PGRacing/WHEEL-07/README.md

# WHEEL-07

obraz
