PGRacing/WHEEL-07/3D_MODEL/HOUSING/HOUSING_WHL.SLDASM

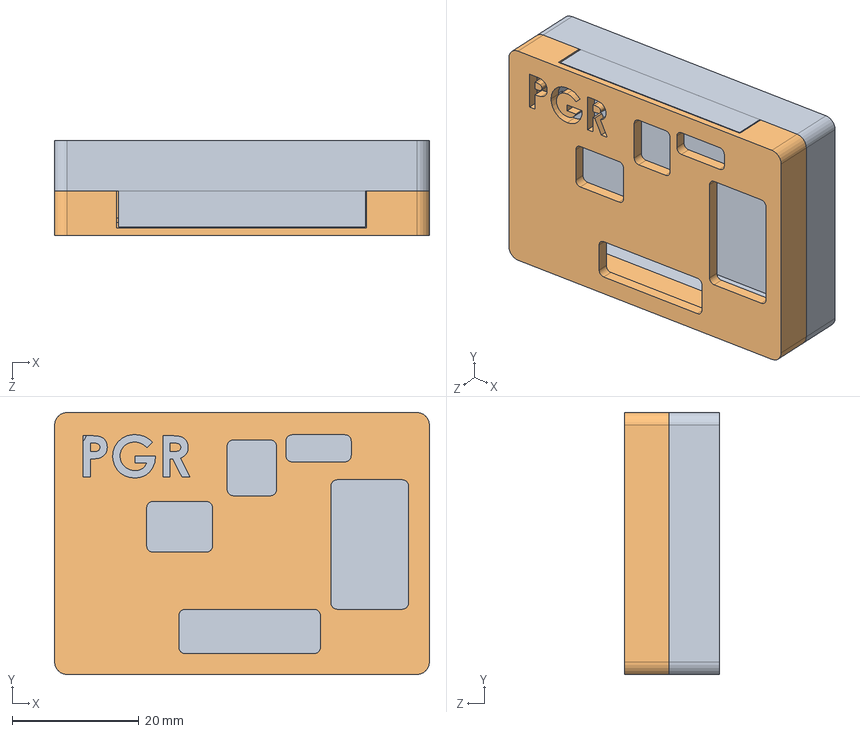
[picture p1: CAD file, 2024-10-11]
3D_MODEL/HOUSING/HOUSING_WHL.SLDASM
59.1 x 41.3 x 15.0 mm
HOUSING_WHL_BOTTOM
HOUSING_WHL_TOP
