PGRacing/WHEEL-07/3D_MODEL/HOUSING/WHEEL-07.step

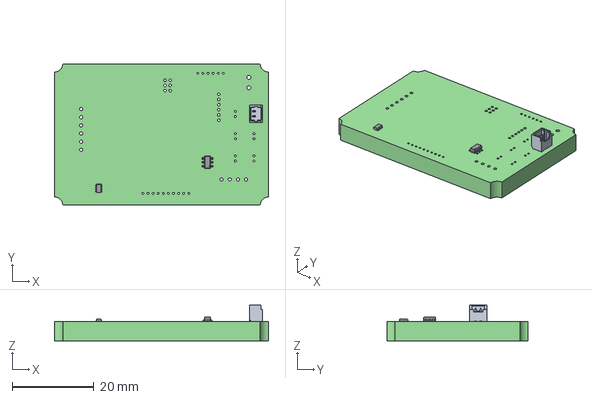
[picture p2: CAD file, 2024-10-11]
3D_MODEL/HOUSING/WHEEL-07.step
52.5 x 34.7 x 8.71 mm
WHEEL-07 PCB
