PGRacing/WHEEL-07/3D_MODEL/KNOBS/Rotary_Knob_V2_FINAL.STL

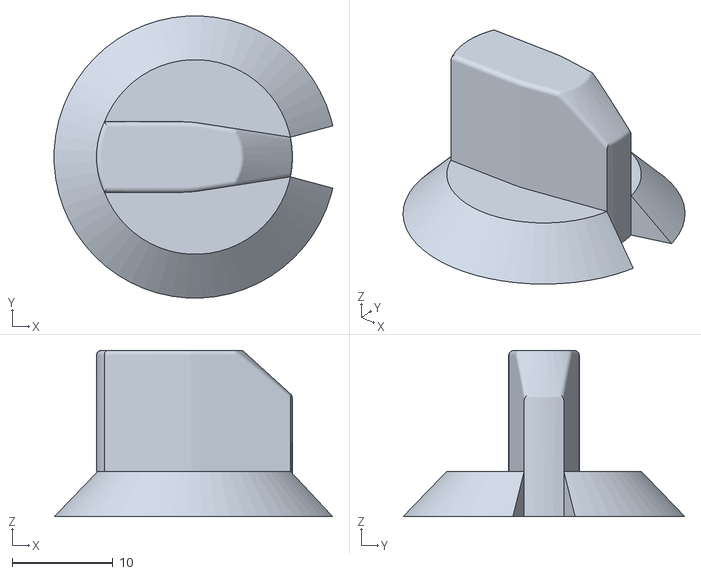
[picture p3: CAD file, 2024-10-06]
3D_MODEL/KNOBS/Rotary_Knob_V2_FINAL.STL
27.6 x 28.0 x 16.5
