PGRacing/WHEEL-07/PCB/WHEEL-07/ADDITIONAL/0022057025/22-05-7025.stp

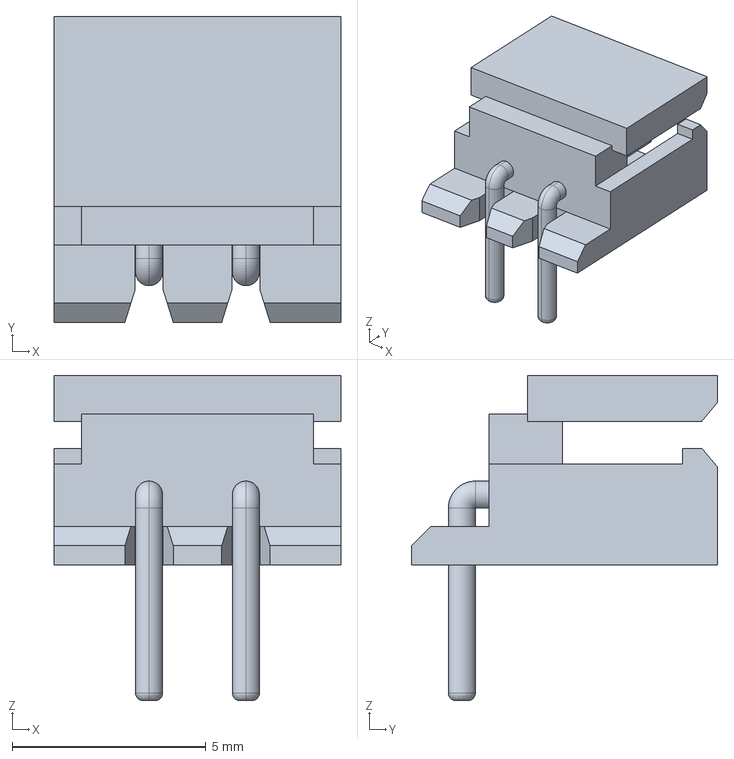
[picture p4: CAD file, 2023-02-24]
PCB/WHEEL-07/ADDITIONAL/0022057025/22-05-7025.stp
7.40 x 7.90 x 8.40 mm
