PGRacing/WHEEL-07/PCB/WHEEL-07/ADDITIONAL/LDO40LPU33RY/LDO40LPU33RY.stp

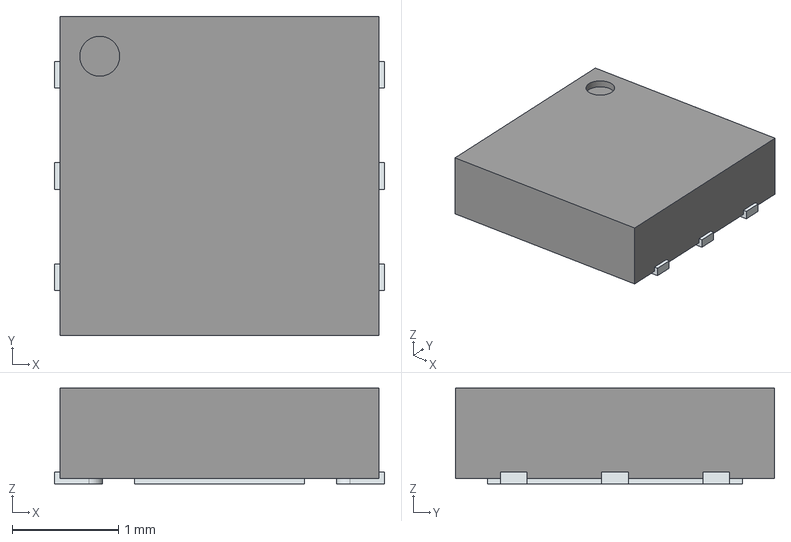
[picture p5: CAD file, 2024-10-12]
PCB/WHEEL-07/ADDITIONAL/LDO40LPU33RY/LDO40LPU33RY.stp
3.10 x 3.00 x 0.9 mm
ThermalPin
PinsArrayLR
