PGRacing/WHEEL-07/PCB/WHEEL-07/WHEEL-07.step

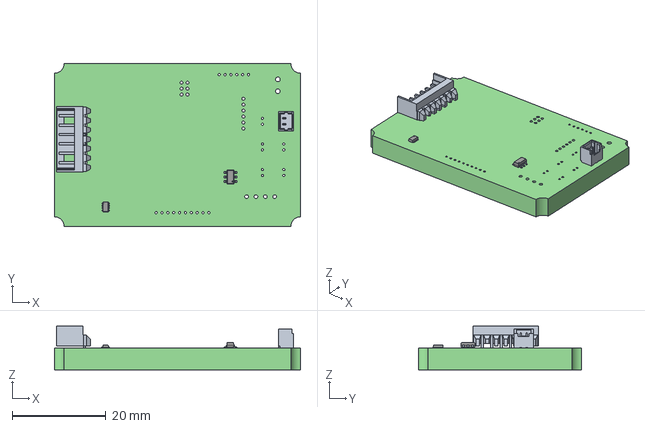
[picture p6: CAD file, 2023-03-17]
PCB/WHEEL-07/WHEEL-07.step
52.5 x 34.7 x 9.34 mm
WHEEL-07 PCB
