PGRacing/WHEEL-07/3D_MODEL/HOUSING/HOUSING_WHL - WHEEL-07.step-1 NL27WZ14DTT1G.step-1 COMPOUND.step-1.STL

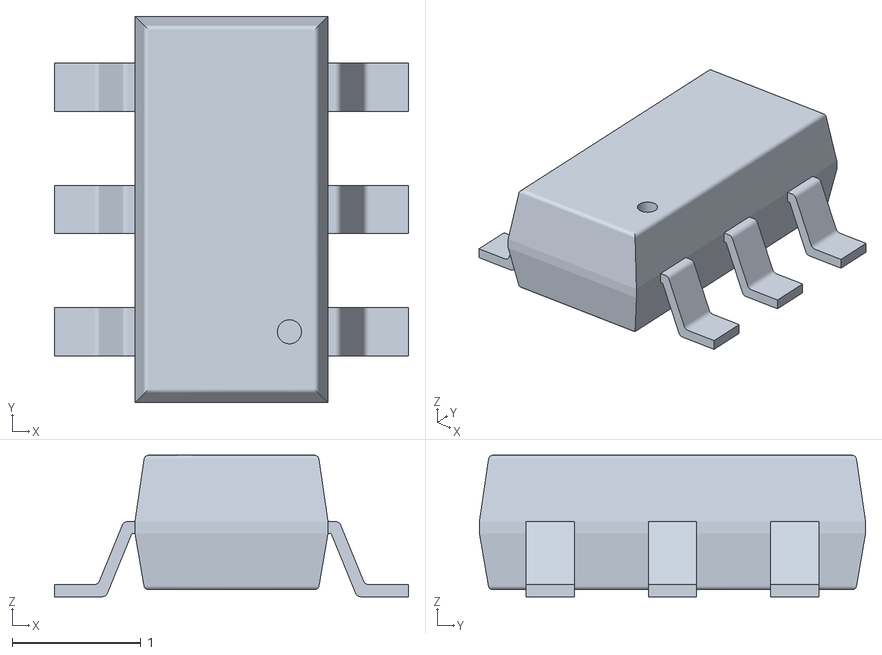
[picture p7: CAD file, 2024-10-11]
3D_MODEL/HOUSING/HOUSING_WHL - WHEEL-07.step-1 NL27WZ14DTT1G.step-1 COMPOUND.step-1.STL
2.75 x 3.00 x 1.10
