PGRacing/WHEEL-07/3D_MODEL/HOUSING/HOUSING_WHL_TOP_V2.STL

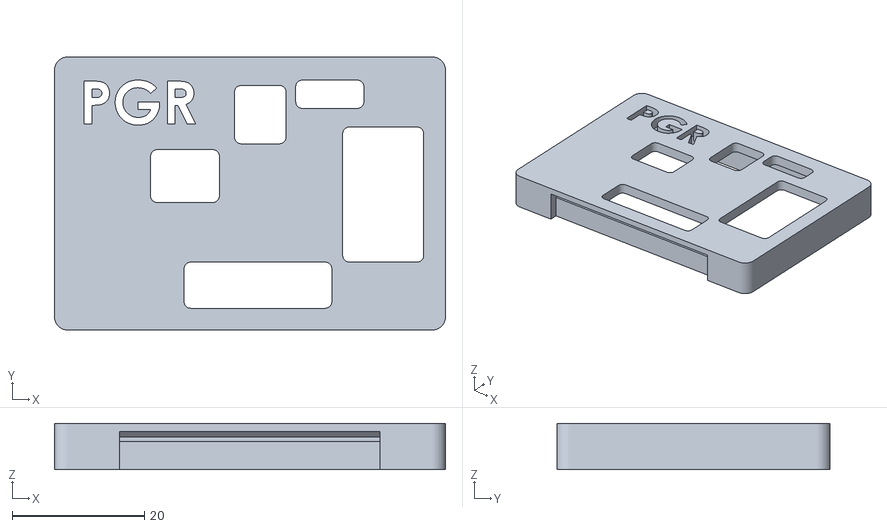
[picture p8: CAD file, 2024-10-11]
3D_MODEL/HOUSING/HOUSING_WHL_TOP_V2.STL
59.1 x 41.3 x 7.00
