PGRacing/WHEEL-07/3D_MODEL/KNOBS/ROTARY_SW.step

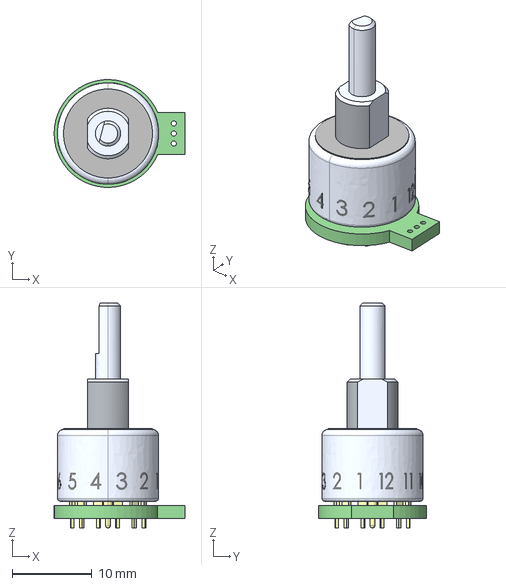
[picture p9: CAD file, 2023-02-25]
3D_MODEL/KNOBS/ROTARY_SW.step
16.4 x 13.5 x 28.2 mm
ROTARY_SW PCB
