PGRacing/WHEEL-07/3D_MODEL/HOUSING/HOUSING_WHL - HOUSING_WHL_BOTTOM-1.STL

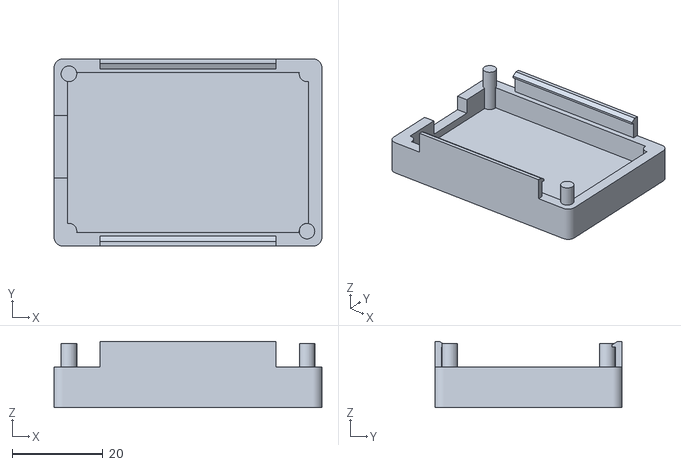
[picture p10: CAD file, 2024-10-11]
3D_MODEL/HOUSING/HOUSING_WHL - HOUSING_WHL_BOTTOM-1.STL
59.1 x 41.3 x 14.6
