PGRacing/WHEEL-07/3D_MODEL/HOUSING/HOUSING_WHL - WHEEL-07.step-1 MP2332HGTL-P.step-1 COMPOUND-1.step-1.STL

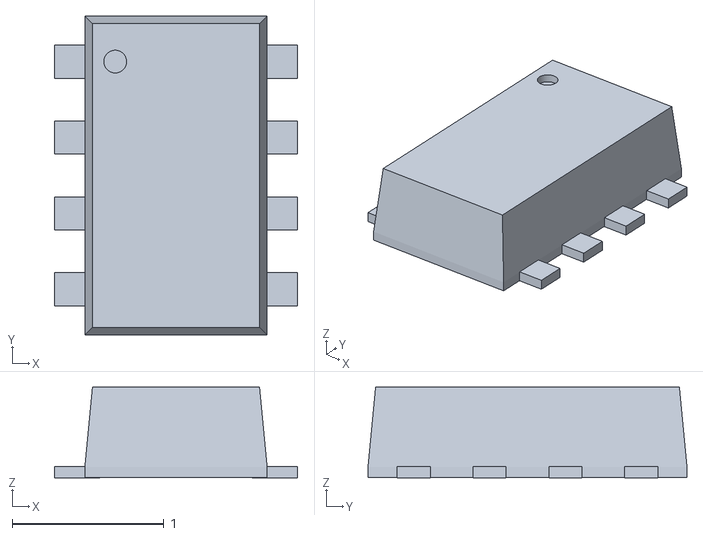
[picture p11: CAD file, 2024-10-11]
3D_MODEL/HOUSING/HOUSING_WHL - WHEEL-07.step-1 MP2332HGTL-P.step-1 COMPOUND-1.step-1.STL
1.60 x 2.10 x 0.598
