PGRacing/WHEEL-07/3D_MODEL/HOUSING/HOUSING_WHL - WHEEL-07.step-1 WHEEL-07 PCB.step-1.STL

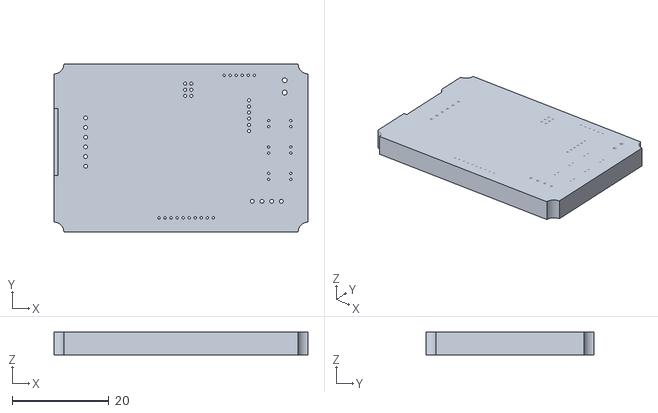
[picture p12: CAD file, 2024-10-11]
3D_MODEL/HOUSING/HOUSING_WHL - WHEEL-07.step-1 WHEEL-07 PCB.step-1.STL
52.5 x 34.7 x 4.69
