PGRacing/WHEEL-07/3D_MODEL/HOUSING/HOUSING_WHL - WHEEL-07.step-1 Molex_PicoBlade_53047-0210_1x02_P1.25mm_Vertical.wrl.step-1 COMPOUND-0.step-1.STL

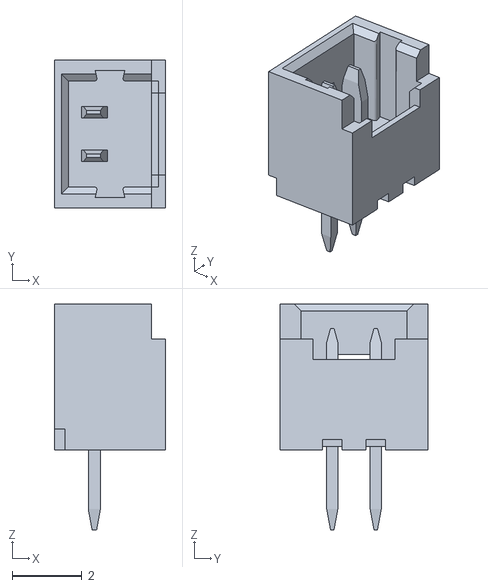
[picture p13: CAD file, 2024-10-11]
3D_MODEL/HOUSING/HOUSING_WHL - WHEEL-07.step-1 Molex_PicoBlade_53047-0210_1x02_P1.25mm_Vertical.wrl.step-1 COMPOUND-0.step-1.STL
3.20 x 4.25 x 6.50
