PGRacing/WHEEL-07/3D_MODEL/HOUSING/HOUSING_WHL_BOTTOM_V2.SLDPRT

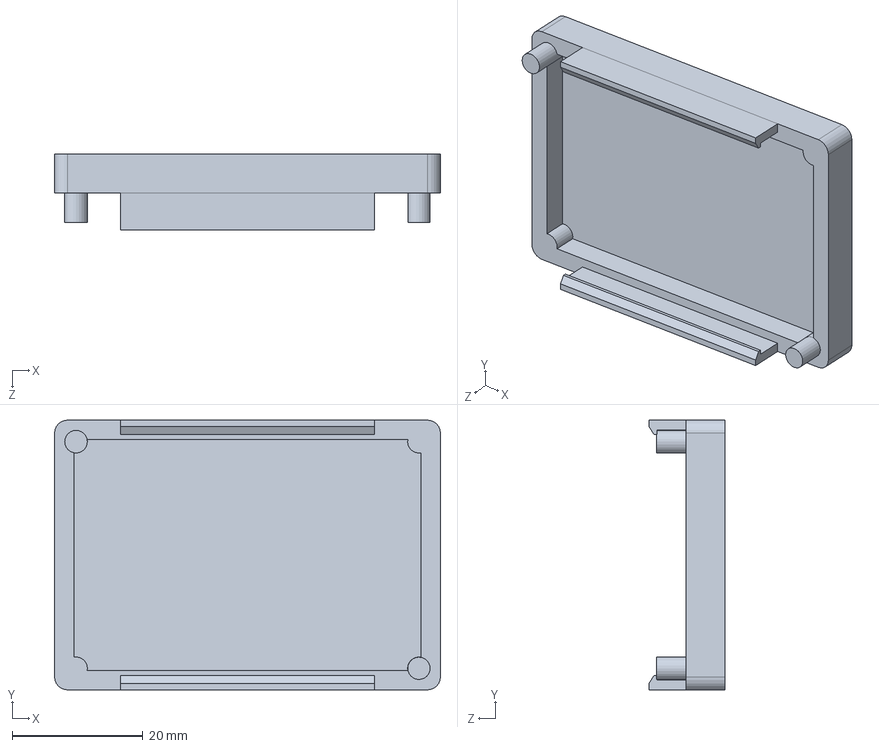
[picture p14: CAD file, 2024-10-11]
3D_MODEL/HOUSING/HOUSING_WHL_BOTTOM_V2.SLDPRT
59.1 x 41.3 x 11.6 mm
