PGRacing/WHEEL-07/(list of files, cad)

Other CAD files:
3D_MODEL/BOARD_WRL_NO_SIZE/wheel-07.wrl.SLDPRT
3D_MODEL/KNOBS/Rotary_Knob.SLDPRT
3D_MODEL/HOUSING/HOUSING_WHL_BOTTOM.SLDPRT
3D_MODEL/HOUSING/HOUSING_WHL_TOP.SLDPRT
3D_MODEL/HOUSING/HOUSING_WHL_BOTTOM_V2.3mf
3D_MODEL/HOUSING/HOUSING_WHL_BOTTOM_V2.STL
3D_MODEL/HOUSING/HOUSING_WHL_TOP.STL
3D_MODEL/KNOBS/ROTARY_SW.SLDASM
3D_MODEL/KNOBS/Rotary_Knob.STL
PCB/WHEEL-07/ADDITIONAL/0022057025/0022057025.stp
PCB/WHEEL-07/ADDITIONAL/53254-0670.stp
PCB/WHEEL-07/ADDITIONAL/87437-0243/87437-0243.stp
PCB/WHEEL-07/ADDITIONAL/87437-0243/87438-0243.stp
PCB/WHEEL-07/WHEEL-07..SLDASM
