PGRacing/WHEEL-07/PCB/WHEEL-07/WHEEL-07.kicad_pcb

## KiCad design PCB/WHEEL-07/WHEEL-07.kicad_pcb (2024-12-15)

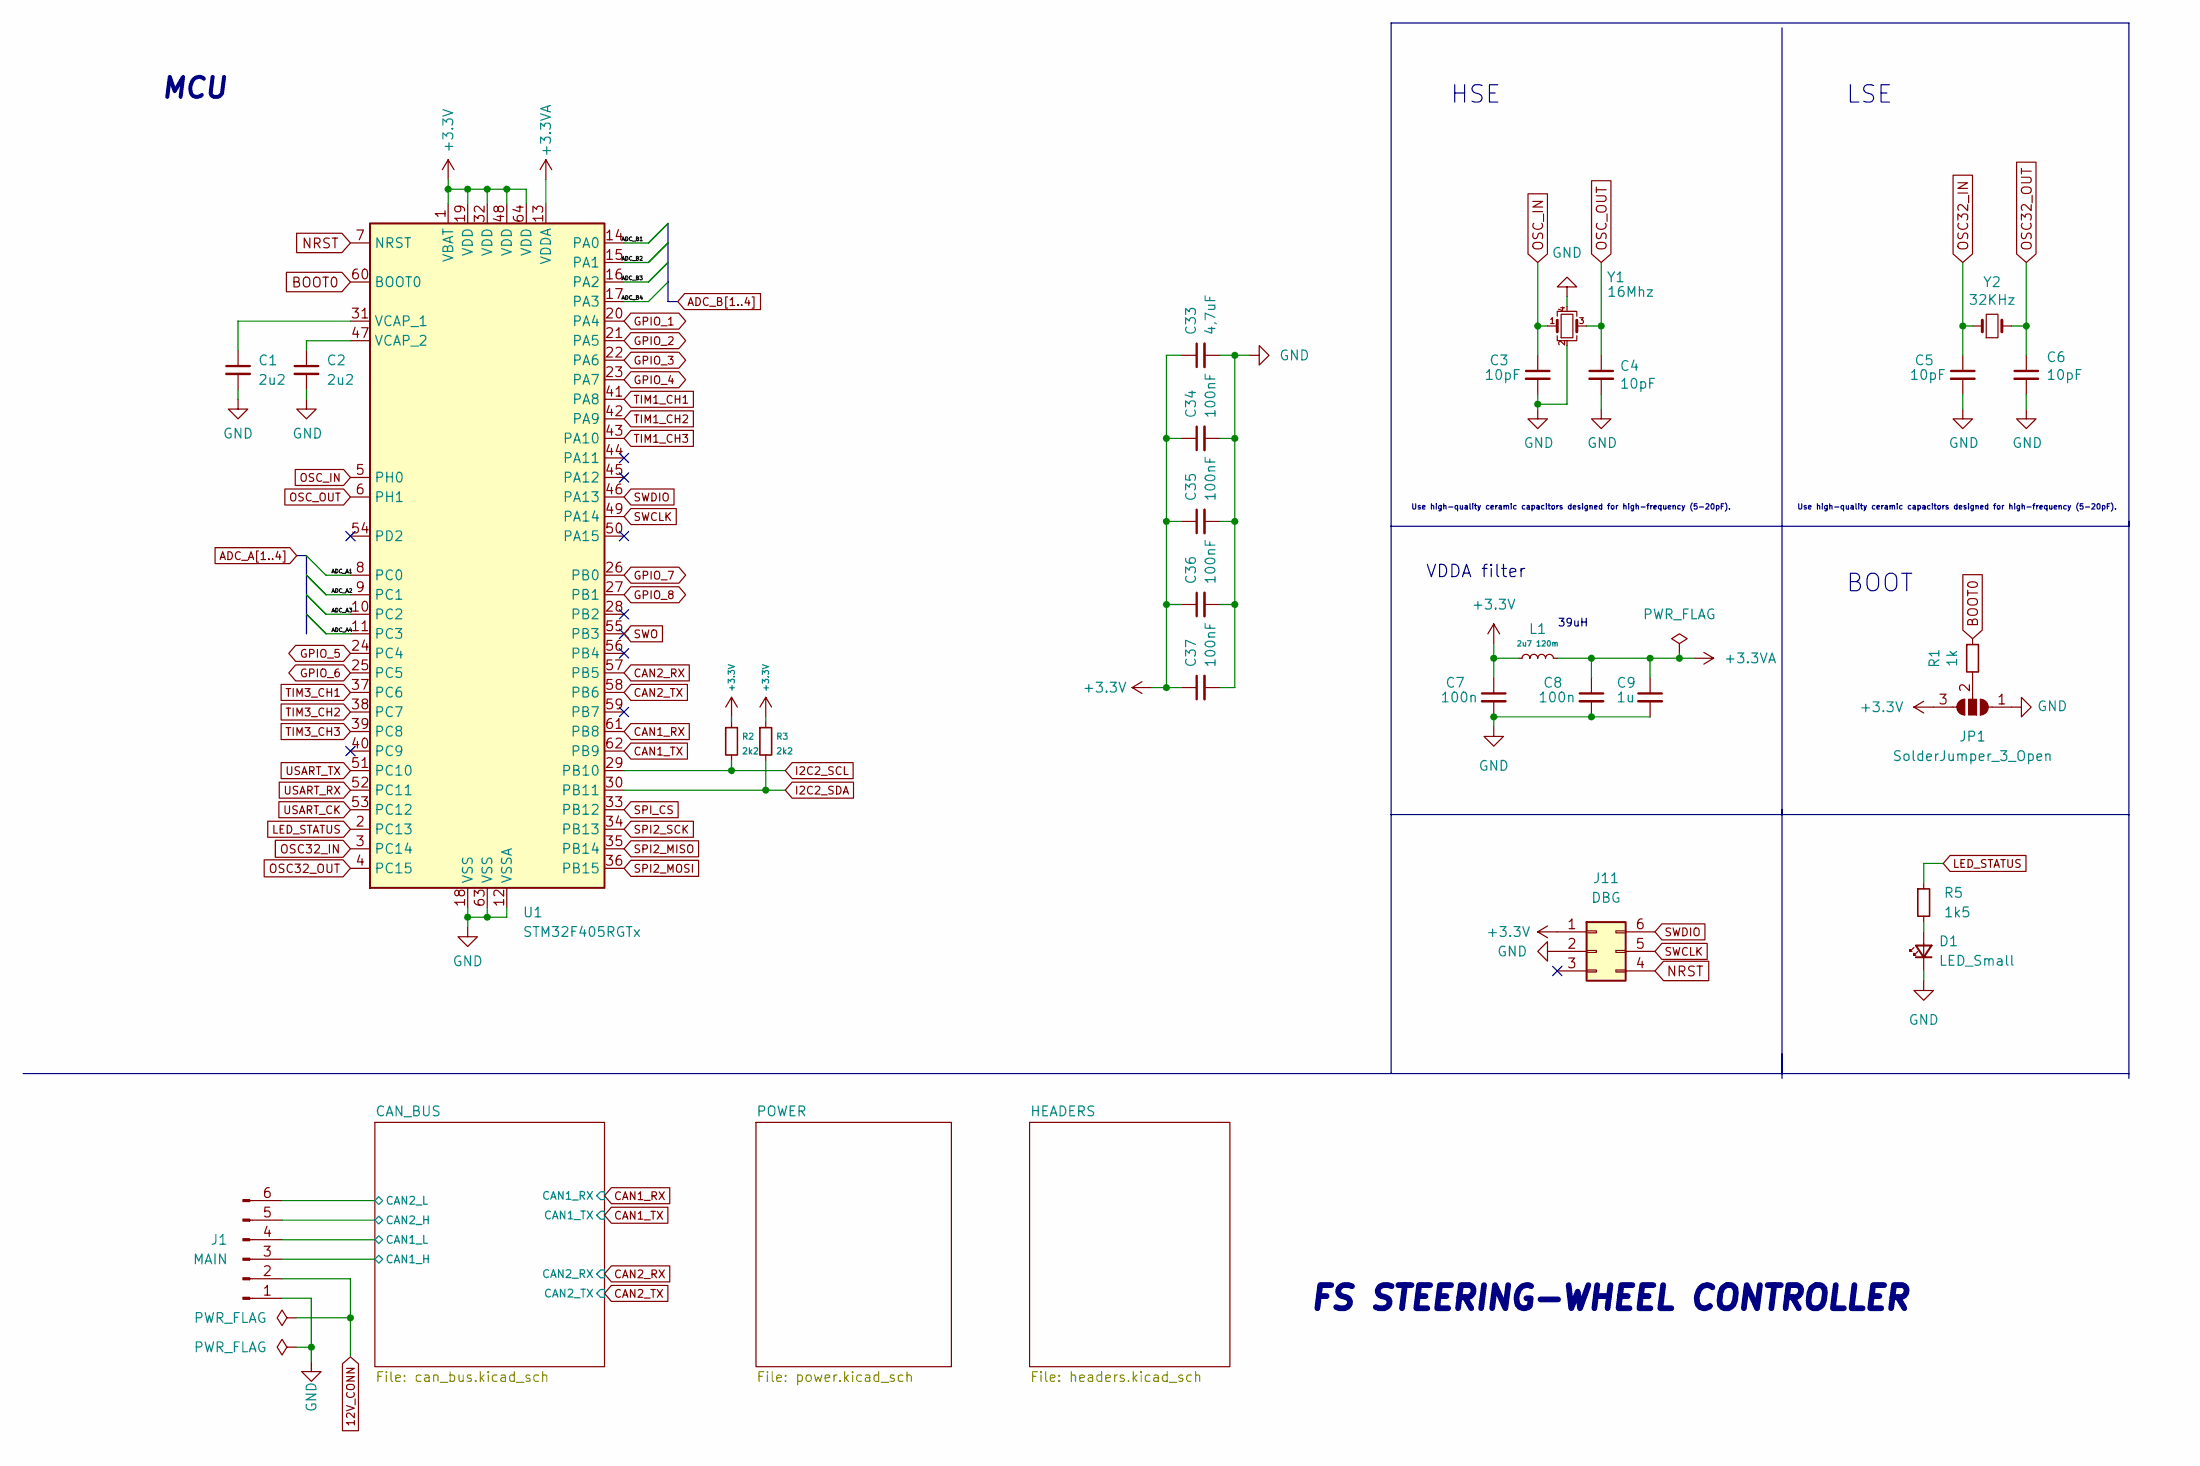
[picture p15: schematic WHEEL-07.kicad_sch]

Parts:
C1, C2: 2u2; C_0402_1005Metric_Pad0.74x0.62mm_HandSolder
C3, C4, C5, C6: 10pF; C_0402_1005Metric_Pad0.74x0.62mm_HandSolder
C7, C8: 100n; C_0402_1005Metric_Pad0.74x0.62mm_HandSolder
C9: 1u; C_0402_1005Metric_Pad0.74x0.62mm_HandSolder
C33: 4,7uF; C_0603_1608Metric
C34, C35, C36, C37: 100nF; C_0402_1005Metric_Pad0.74x0.62mm_HandSolder
D1: LED_Small; LED_0805_2012Metric
J1: MAIN; Molex_Micro-Latch_53254-0670_1x06_P2.00mm_Horizontal
J11: DBG; PinHeader_2x03_P1.27mm_Vertical
JP1: SolderJumper_3_Open; SolderJumper-3_P1.3mm_Open_RoundedPad1.0x1.5mm
L1: 2u7 120m; L_0402_1005Metric
R1: 1k; R_0402_1005Metric_Pad0.72x0.64mm_HandSolder
R2, R3: 2k2; R_0402_1005Metric_Pad0.72x0.64mm_HandSolder
R5: 1k5; R_0402_1005Metric_Pad0.72x0.64mm_HandSolder
U1: STM32F405RGTx; LQFP-64_10x10mm_P0.5mm
Y1: 16Mhz; Crystal_SMD_2016-4Pin_2.0x1.6mm
Y2: 32KHz; Crystal_SMD_3215-2Pin_3.2x1.5mm

Connections:
12V_CONN: J1.2; also elsewhere on the board
+3.3V: C7.1, C33.1, C34.1, C35.1, C36.1, C37.1, J11.1, JP1.3 (B), L1.1, R2.1, R3.1, U1.1 (VBAT), U1.19 (VDD), U1.32 (VDD), U1.48 (VDD), U1.64 (VDD); also elsewhere on the board
+3.3VA: C8.1, C9.1, L1.2, U1.13 (VDDA)
/CAN_BUS/CAN1_H: J1.3; also elsewhere on the board
/CAN_BUS/CAN1_L: J1.4; also elsewhere on the board
/CAN_BUS/CAN2_H: J1.5; also elsewhere on the board
/CAN_BUS/CAN2_L: J1.6; also elsewhere on the board
ADC_A1: U1.8 (PC0); also elsewhere on the board
ADC_A2: U1.9 (PC1); also elsewhere on the board
ADC_A3: U1.10 (PC2); also elsewhere on the board
ADC_A4: U1.11 (PC3); also elsewhere on the board
ADC_B1: U1.14 (PA0); also elsewhere on the board
ADC_B2: U1.15 (PA1); also elsewhere on the board
ADC_B3: U1.16 (PA2); also elsewhere on the board
ADC_B4: U1.17 (PA3); also elsewhere on the board
BOOT0: R1.1, U1.60 (BOOT0)
CAN1_RX: U1.61 (PB8); also elsewhere on the board
CAN1_TX: U1.62 (PB9); also elsewhere on the board
CAN2_RX: U1.57 (PB5); also elsewhere on the board
CAN2_TX: U1.58 (PB6); also elsewhere on the board
GND: C1.2, C2.2, C3.2, C4.2, C5.2, C6.2, C7.2, C8.2, C9.2, C33.2, C34.2, C35.2, C36.2, C37.2, D1.1 (K), J1.1, J11.2, JP1.1 (A), U1.12 (VSSA), U1.18 (VSS), U1.63 (VSS), Y1.2, Y1.4; also elsewhere on the board
GPIO_1: U1.20 (PA4); also elsewhere on the board
GPIO_2: U1.21 (PA5); also elsewhere on the board
GPIO_3: U1.22 (PA6); also elsewhere on the board
GPIO_4: U1.23 (PA7); also elsewhere on the board
GPIO_5: U1.24 (PC4); also elsewhere on the board
GPIO_6: U1.25 (PC5); also elsewhere on the board
GPIO_7: U1.26 (PB0); also elsewhere on the board
GPIO_8: U1.27 (PB1); also elsewhere on the board
I2C2_SCL: R2.2, U1.29 (PB10); also elsewhere on the board
I2C2_SDA: R3.2, U1.30 (PB11); also elsewhere on the board
LED_STATUS: R5.1, U1.2 (PC13)
NRST: J11.4, U1.7 (NRST)
unnamed: C1.1, U1.31 (VCAP_1)
unnamed: C2.1, U1.47 (VCAP_2)
unnamed: D1.2 (A), R5.2
unnamed: JP1.2 (C), R1.2
OSC32_IN: C5.1, U1.3 (PC14), Y2.1
OSC32_OUT: C6.1, U1.4 (PC15), Y2.2
OSC_IN: C3.1, U1.5 (PH0), Y1.1
OSC_OUT: C4.1, U1.6 (PH1), Y1.3
SPI2_MISO: U1.35 (PB14); also elsewhere on the board
SPI2_MOSI: U1.36 (PB15); also elsewhere on the board
SPI2_SCK: U1.34 (PB13); also elsewhere on the board
SPI_CS: U1.33 (PB12); also elsewhere on the board
SWCLK: J11.5, U1.49 (PA14)
SWDIO: J11.6, U1.46 (PA13)
SWO: U1.55 (PB3)
TIM1_CH1: U1.41 (PA8); also elsewhere on the board
TIM1_CH2: U1.42 (PA9); also elsewhere on the board
TIM1_CH3: U1.43 (PA10); also elsewhere on the board
TIM3_CH1: U1.37 (PC6); also elsewhere on the board
TIM3_CH2: U1.38 (PC7); also elsewhere on the board
TIM3_CH3: U1.39 (PC8); also elsewhere on the board
USART_CK: U1.53 (PC12)
USART_RX: U1.52 (PC11)
USART_TX: U1.51 (PC10)

Notes on the sheet:
39uH
LSE
MCU
BOOT
Use high-quality ceramic capacitors designed for high-frequency (5-20pF).
HSE
VDDA filter
FS STEERING-WHEEL CONTROLLER

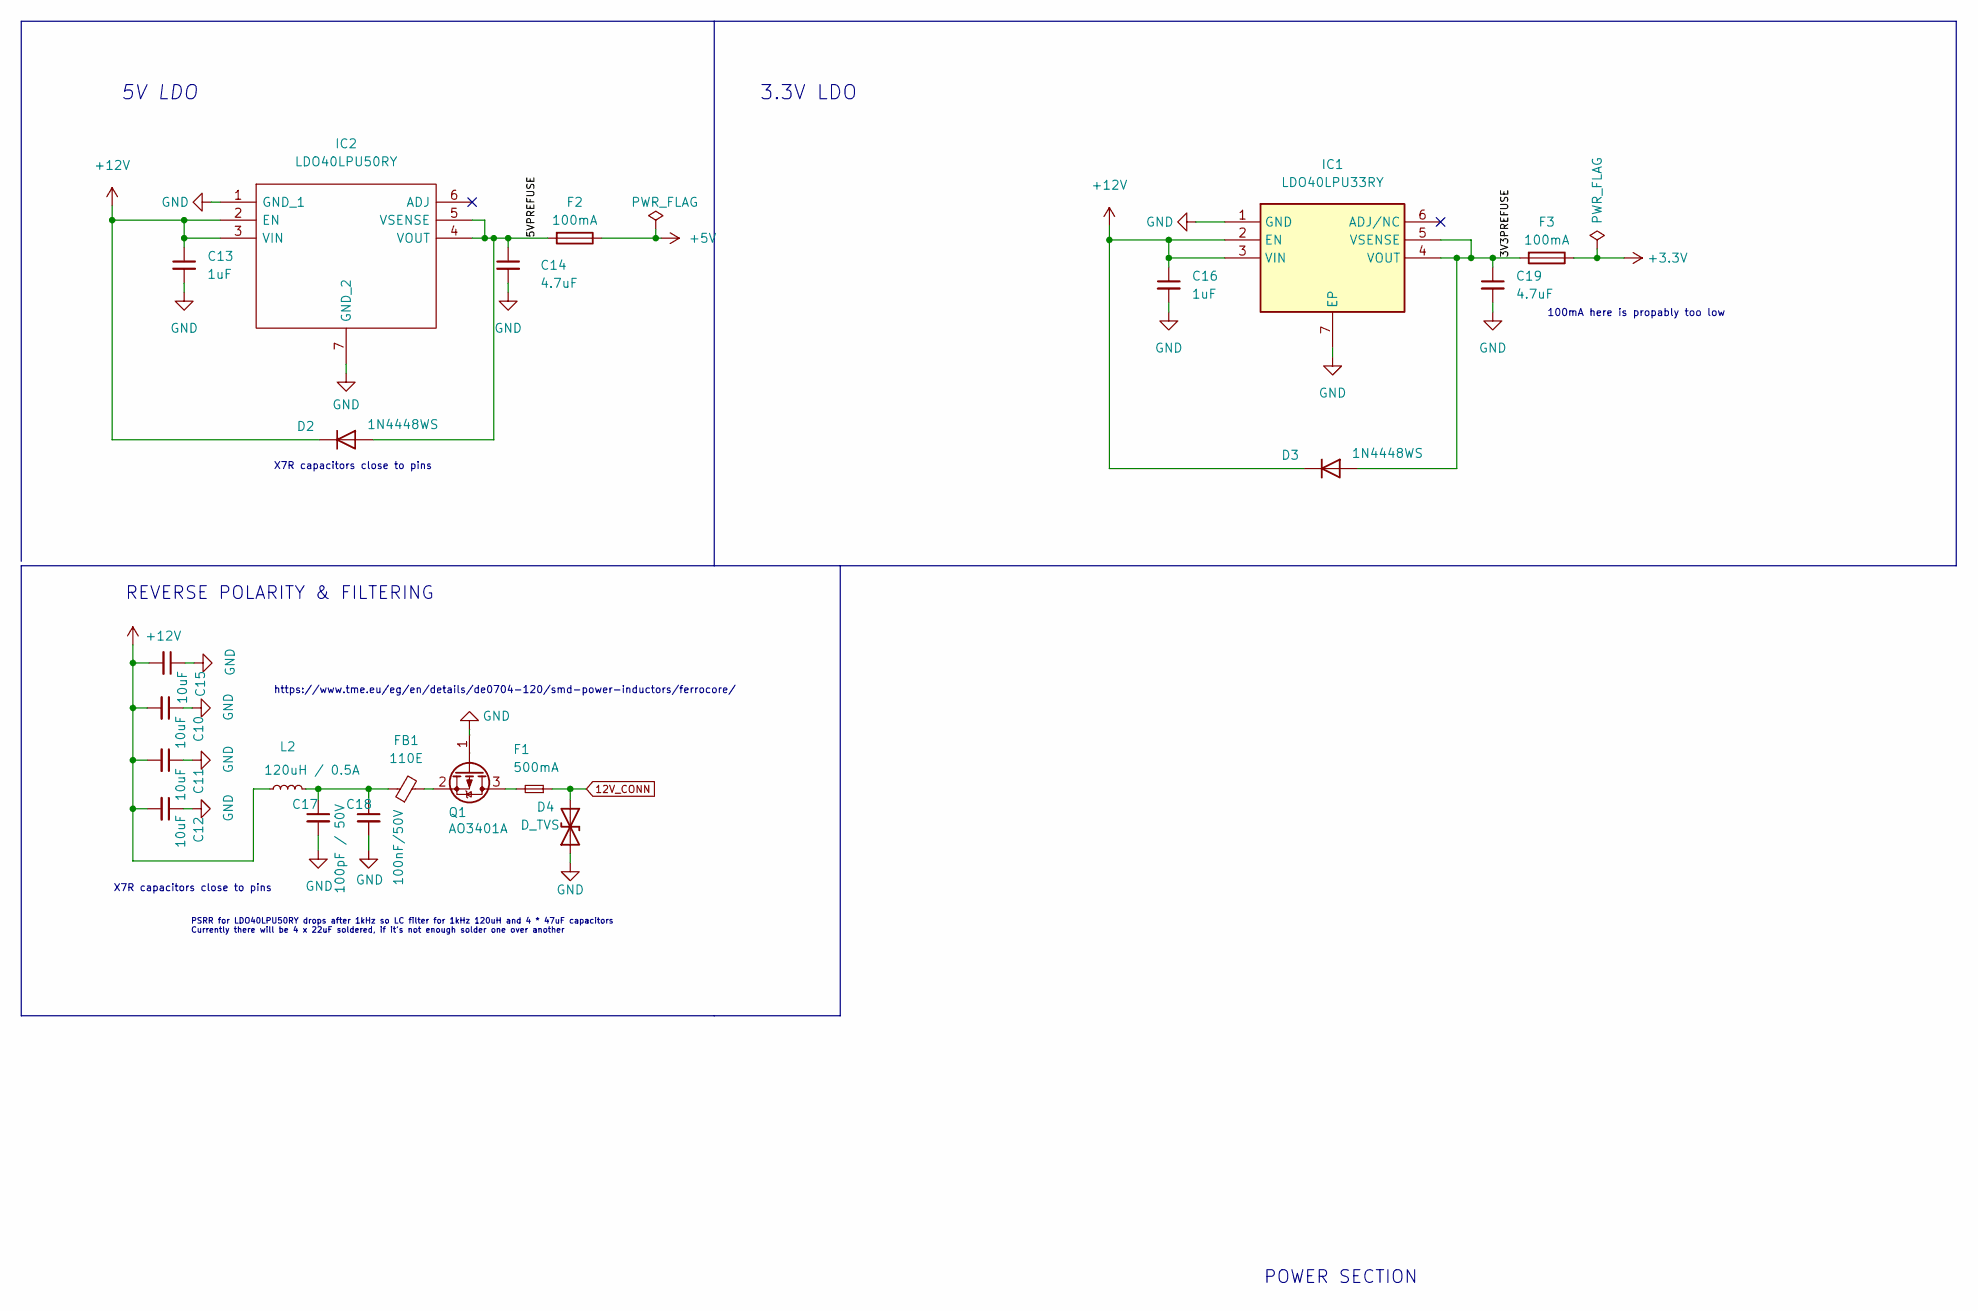
[picture p16: schematic power.kicad_sch]

Parts:
C10, C11, C12, C15: 10uF; C_1206_3216Metric
C13, C16: 1uF; C_0805_2012Metric
C14, C19: 4.7uF; C_0603_1608Metric
C17: 100pF / 50V; C_0402_1005Metric
C18: 100nF/50V; C_0402_1005Metric
D2, D3: 1N4448WS; D_SOD-323
D4: D_TVS; D_SMA
F1: 500mA; Fuse_0805_2012Metric
F2, F3: 100mA; Fuse_0805_2012Metric
FB1: 110E; LED_0805_2012Metric
IC1: LDO40LPU33RY; SON95P300X300X90-7N-D; Manufacturer_Part_Number LDO40LPU33RY; Mouser Part Number 511-LDO40LPU33RY
IC2: LDO40LPU50RY; SON95P300X300X90-7N-D; Manufacturer_Part_Number LDO40LPU50RY; Mouser Part Number 511-LDO40LPU50RY
L2: 120uH / 0.5A; L_7.3x7.3_H4.5
Q1: AO3401A; SOT-23

Connections:
12V_CONN: D4.2 (A2), F1.1; also elsewhere on the board
+3.3V: F3.1; also elsewhere on the board
+5V: F2.1; also elsewhere on the board
+12V: C10.2, C11.2, C12.2, C13.1, C15.2, C16.1, D2.1 (K), D3.1 (K), IC1.2 (EN), IC1.3 (VIN), IC2.2 (EN), IC2.3 (VIN), L2.1
/POWER/3V3PREFUSE: C19.1, D3.2 (A), F3.2, IC1.4 (VOUT), IC1.5 (VSENSE)
/POWER/5VPREFUSE: C14.1, D2.2 (A), F2.2, IC2.4 (VOUT), IC2.5 (VSENSE)
GND: C10.1, C11.1, C12.1, C13.2, C14.2, C15.1, C16.2, C17.2, C18.2, C19.2, D4.1 (A1), IC1.1 (GND), IC1.7 (EP), IC2.1 (GND_1), IC2.7 (GND_2), Q1.1 (G); also elsewhere on the board
unnamed: C17.1, C18.1, FB1.1, L2.2
unnamed: F1.2, Q1.3 (D)
unnamed: FB1.2, Q1.2 (S)

Notes on the sheet:
X7R capacitors close to pins
POWER SECTION
100mA here is propably too low
PSRR for LDO40LPU50RY drops after 1kHz so LC filter for 1kHz 120uH and 4 * 47uF capacitors Currently there will be 4 x 22uF soldered, if it's not enough solder one over another
https://www.tme.eu/eg/en/details/de0704-120/smd-power-inductors/ferrocore/
3.3V LDO
5V LDO
REVERSE POLARITY & FILTERING

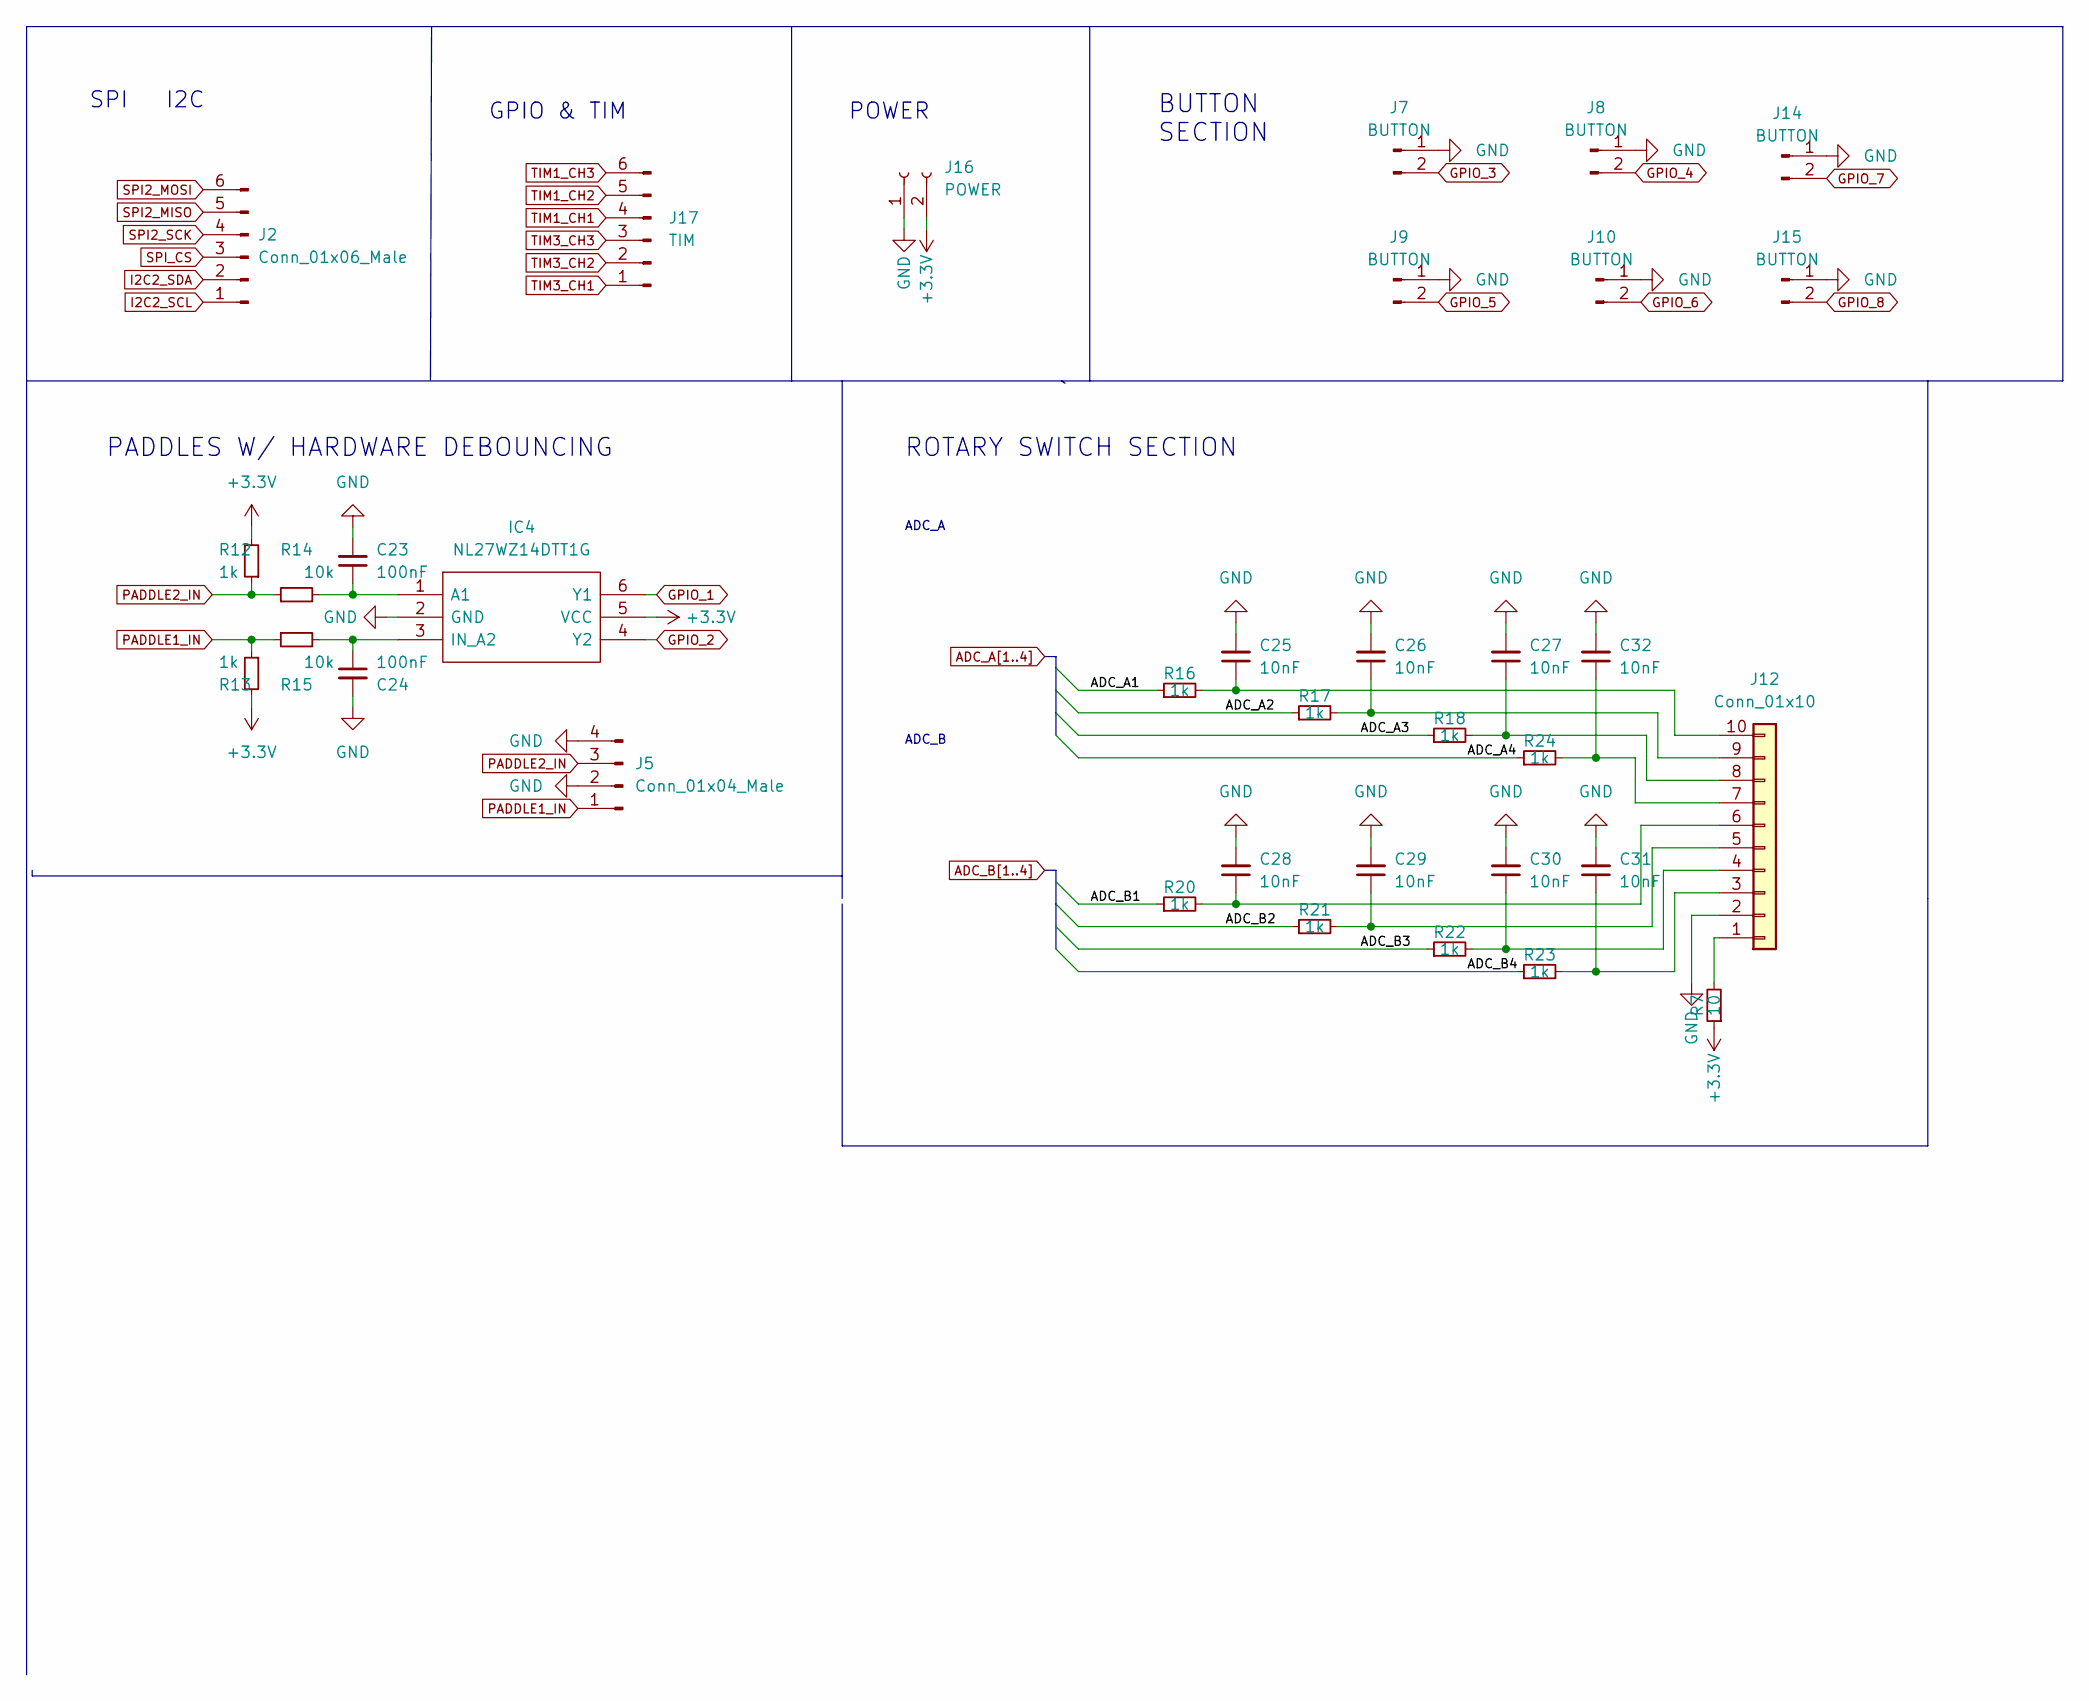
[picture p17: schematic headers.kicad_sch]

Parts:
C23, C24: 100nF; C_0402_1005Metric_Pad0.74x0.62mm_HandSolder
C25, C26, C27, C28, C29, C30, C31, C32: 10nF; C_0402_1005Metric_Pad0.74x0.62mm_HandSolder
IC4: NL27WZ14DTT1G; SOT95P275X110-6N; Manufacturer_Part_Number NL27WZ14DTT1G; Mouser Part Number 863-NL27WZ14DTT1G
J2: Conn_01x06_Male; PinHeader_1x06_P1.27mm_Vertical
J5: Conn_01x04_Male; Molex_Micro-Latch_53254-0470_1x04_P2.00mm_Horizontal
J7, J8, J9, J10, J14, J15: BUTTON; Molex_PicoBlade_53047-0210_1x02_P1.25mm_Vertical
J12: Conn_01x10; Molex_PicoBlade_53047-1010_1x10_P1.25mm_Vertical
J16: POWER; PinHeader_1x02_P2.54mm_Vertical
J17: TIM; Molex_PicoBlade_53047-0610_1x06_P1.25mm_Vertical
R7: 10; R_0805_2012Metric
R12, R13, R16, R17, R18, R20, R21, R22, R23, R24: 1k; R_0402_1005Metric_Pad0.72x0.64mm_HandSolder
R14, R15: 10k; R_0402_1005Metric_Pad0.72x0.64mm_HandSolder

Connections:
+3.3V: IC4.5 (VCC), J16.2, R7.1, R12.2, R13.2; also elsewhere on the board
ADC_A1: R16.1; also elsewhere on the board
ADC_A2: R17.1; also elsewhere on the board
ADC_A3: R18.1; also elsewhere on the board
ADC_A4: R24.1; also elsewhere on the board
ADC_B1: R20.1; also elsewhere on the board
ADC_B2: R21.1; also elsewhere on the board
ADC_B3: R22.1; also elsewhere on the board
ADC_B4: R23.1; also elsewhere on the board
GND: C23.2, C24.2, C25.2, C26.2, C27.2, C28.2, C29.2, C30.2, C31.2, C32.2, IC4.2 (GND), J5.2, J5.4, J7.1, J8.1, J9.1, J10.1, J12.2, J14.1, J15.1, J16.1; also elsewhere on the board
GPIO_1: IC4.6 (Y1); also elsewhere on the board
GPIO_2: IC4.4 (Y2); also elsewhere on the board
GPIO_3: J7.2; also elsewhere on the board
GPIO_4: J8.2; also elsewhere on the board
GPIO_5: J9.2; also elsewhere on the board
GPIO_6: J10.2; also elsewhere on the board
GPIO_7: J14.2; also elsewhere on the board
GPIO_8: J15.2; also elsewhere on the board
I2C2_SCL: J2.1; also elsewhere on the board
I2C2_SDA: J2.2; also elsewhere on the board
unnamed: C23.1, IC4.1 (A1), R14.2
unnamed: C24.1, IC4.3 (IN_A2), R15.2
unnamed: C25.1, J12.10, R16.2
unnamed: C26.1, J12.9, R17.2
unnamed: C27.1, J12.8, R18.2
unnamed: C28.1, J12.6, R20.2
unnamed: C29.1, J12.5, R21.2
unnamed: C30.1, J12.4, R22.2
unnamed: C31.1, J12.3, R23.2
unnamed: C32.1, J12.7, R24.2
unnamed: J12.1, R7.2
PADDLE1_IN: J5.1, R13.1, R15.1
PADDLE2_IN: J5.3, R12.1, R14.1
SPI2_MISO: J2.5; also elsewhere on the board
SPI2_MOSI: J2.6; also elsewhere on the board
SPI2_SCK: J2.4; also elsewhere on the board
SPI_CS: J2.3; also elsewhere on the board
TIM1_CH1: J17.4; also elsewhere on the board
TIM1_CH2: J17.5; also elsewhere on the board
TIM1_CH3: J17.6; also elsewhere on the board
TIM3_CH1: J17.1; also elsewhere on the board
TIM3_CH2: J17.2; also elsewhere on the board
TIM3_CH3: J17.3; also elsewhere on the board

Notes on the sheet:
POWER
BUTTON SECTION
ADC_A
PADDLES W/ HARDWARE DEBOUNCING
ROTARY SWITCH SECTION
ADC_B
GPIO & TIM
I2C
SPI

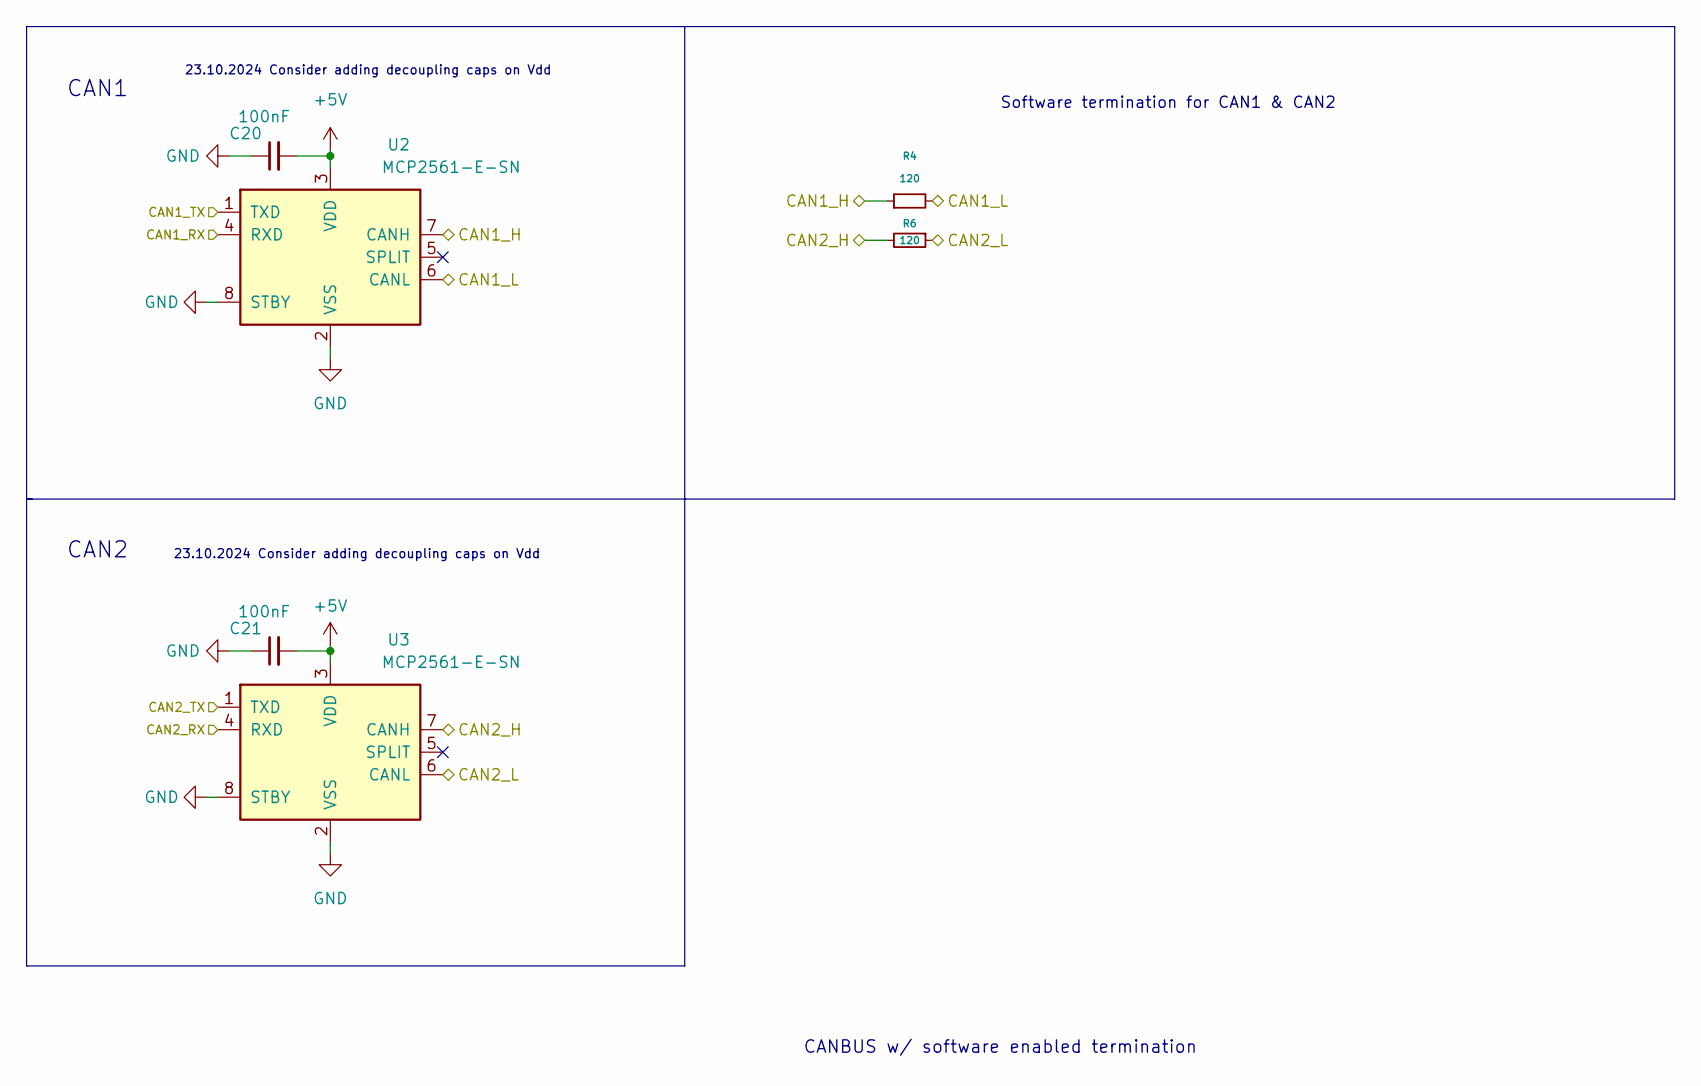
[picture p18: schematic can_bus.kicad_sch]

Parts:
C20, C21: 100nF; C_0402_1005Metric_Pad0.74x0.62mm_HandSolder
R4, R6: 120; R_0402_1005Metric_Pad0.72x0.64mm_HandSolder
U2, U3: MCP2561-E-SN; SOIC-8_3.9x4.9mm_P1.27mm

Connections:
+5V: C20.2, C21.2, U2.3 (VDD), U3.3 (VDD); also elsewhere on the board
/CAN_BUS/CAN1_H: R4.1, U2.7 (CANH); also elsewhere on the board
/CAN_BUS/CAN1_L: R4.2, U2.6 (CANL); also elsewhere on the board
/CAN_BUS/CAN2_H: R6.2, U3.7 (CANH); also elsewhere on the board
/CAN_BUS/CAN2_L: R6.1, U3.6 (CANL); also elsewhere on the board
CAN1_RX: U2.4 (RXD); also elsewhere on the board
CAN1_TX: U2.1 (TXD); also elsewhere on the board
CAN2_RX: U3.4 (RXD); also elsewhere on the board
CAN2_TX: U3.1 (TXD); also elsewhere on the board
GND: C20.1, C21.1, U2.2 (VSS), U2.8 (STBY), U3.2 (VSS), U3.8 (STBY); also elsewhere on the board

Notes on the sheet:
Software termination for CAN1 & CAN2
CANBUS w/ software enabled termination
CAN1
CAN2
23.10.2024 Consider adding decoupling caps on Vdd

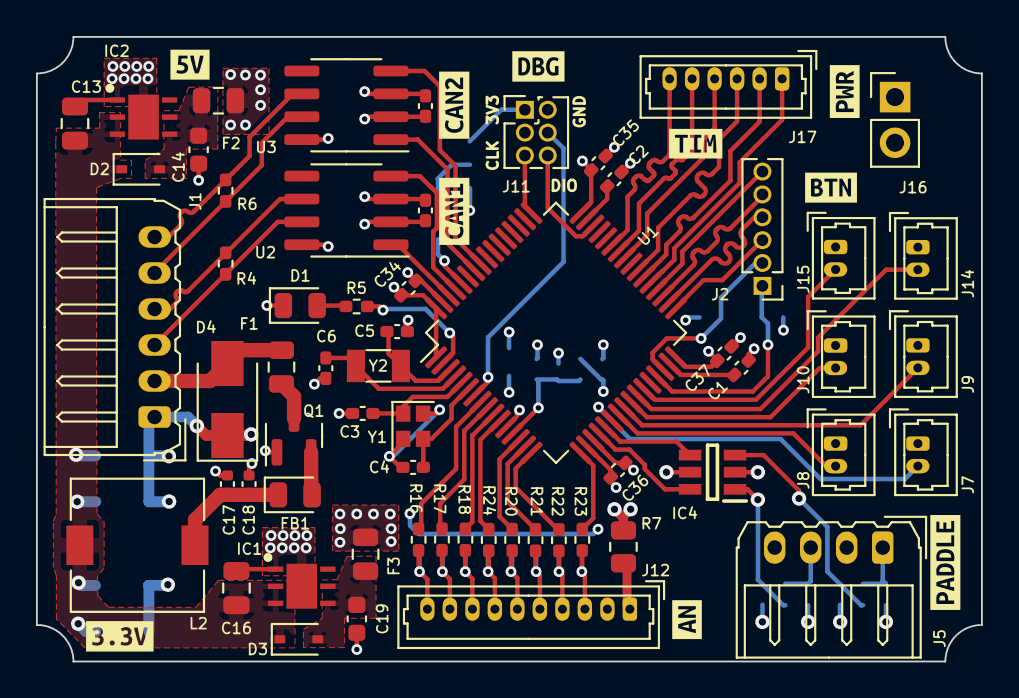
[picture p19: board WHEEL-07.kicad_pcb from above]

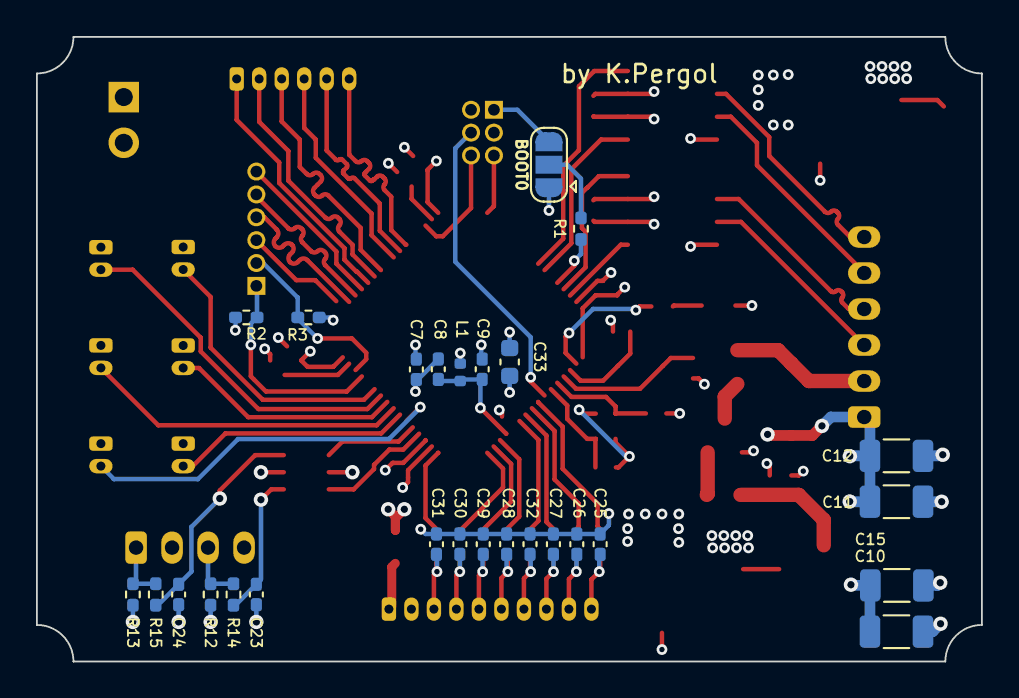
[picture p20: board WHEEL-07.kicad_pcb from below]

Board: 4 copper layers, 52.5 x 34.7 mm, 98 parts (27 on the bottom side), 73 nets.

Other parts of the board:
kibuzzard-6414F4C6: G***; kibuzzard-6414F4C6
kibuzzard-64076DC9: G***; kibuzzard-64076DC9
kibuzzard-64076DD2: G***; kibuzzard-64076DD2
kibuzzard-64076DF0: G***; kibuzzard-64076DF0
kibuzzard-64076DFA: G***; kibuzzard-64076DFA
kibuzzard-64076E40: G***; kibuzzard-64076E40
kibuzzard-64076F6A: G***; kibuzzard-64076F6A
kibuzzard-64135F75: G***; kibuzzard-64135F75
kibuzzard-64135F81: G***; kibuzzard-64135F81
kibuzzard-64137017: G***; kibuzzard-64137017
