PGRacing/WHEEL-07/PCB/ROTARY_SW/ROTARY_SW.kicad_pcb

## KiCad design PCB/ROTARY_SW/ROTARY_SW.kicad_pcb (2023-06-10)

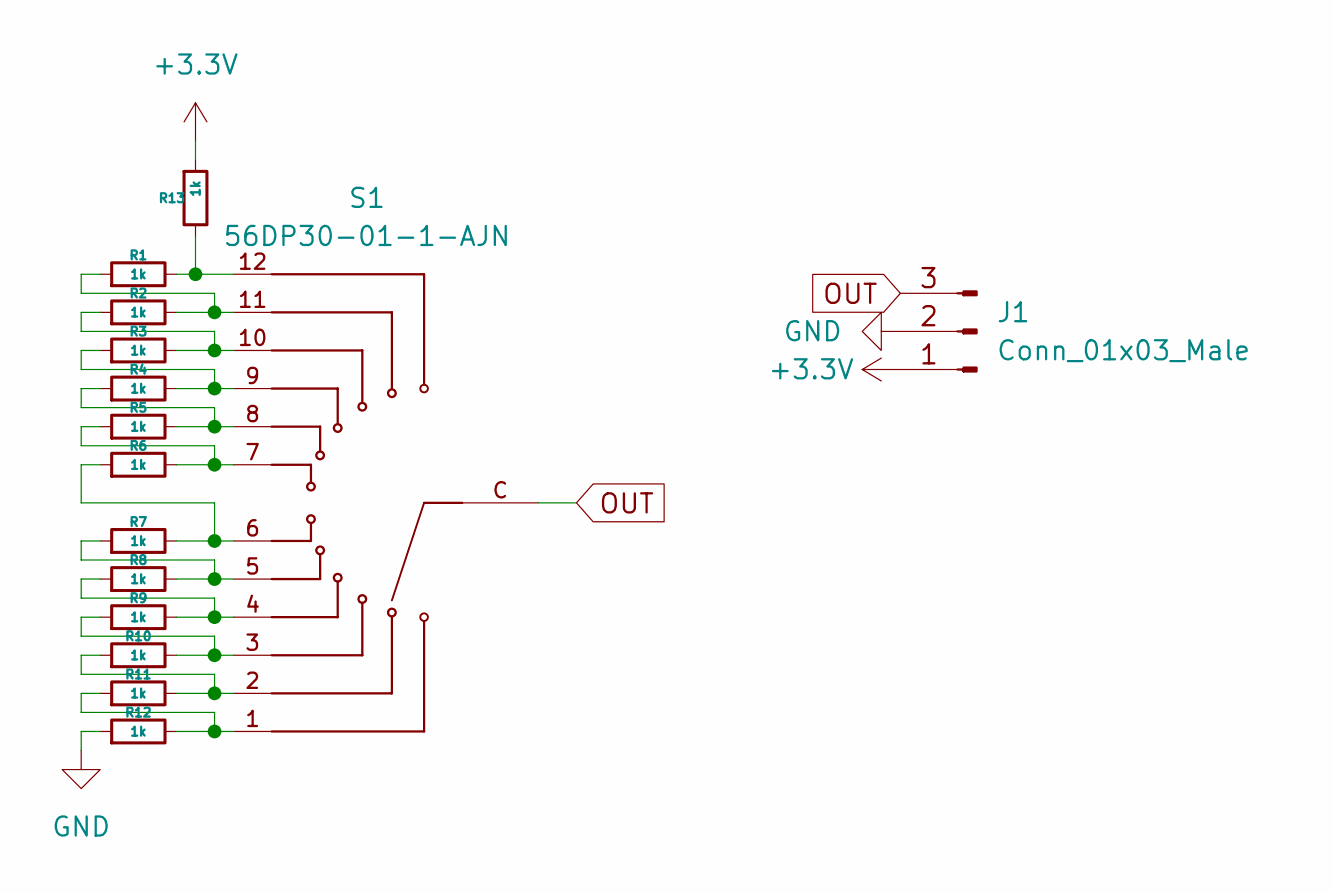
[picture p21: schematic ROTARY_SW.kicad_sch]

Parts:
J1: Conn_01x03_Male; PinHeader_1x03_P1.27mm_Vertical
R1, R2, R3, R4, R5, R6, R7, R8, R9, R10, R11, R12, R13: 1k; R_0402_1005Metric
S1: 56DP30-01-1-AJN; SW_56DP30-01-1-AJN; PARTREV 04/14

Connections:
+3.3V: J1.1, R13.1
GND: J1.2, R12.1
unnamed: R1.1, R2.2, S1.11
unnamed: R1.2, R13.2, S1.12
unnamed: R2.1, R3.2, S1.10
unnamed: R3.1, R4.2, S1.9
unnamed: R4.1, R5.2, S1.8
unnamed: R5.1, R6.2, S1.7
unnamed: R6.1, R7.2, S1.6
unnamed: R7.1, R8.2, S1.5
unnamed: R8.1, R9.2, S1.4
unnamed: R10.1, R11.2, S1.2
unnamed: R9.1, R10.2, S1.3
unnamed: R11.1, R12.2, S1.1
OUT: J1.3, S1.C

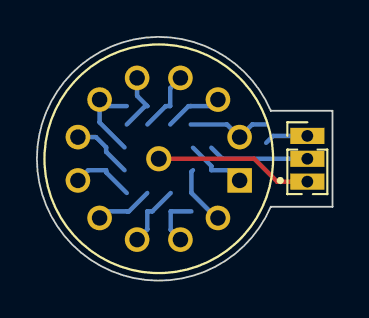
[picture p22: board ROTARY_SW.kicad_pcb from above]

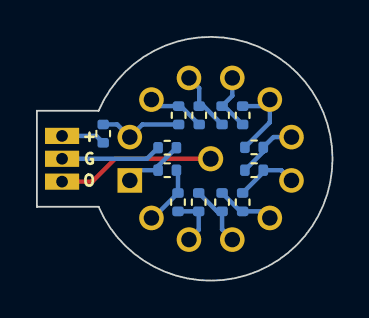
[picture p23: board ROTARY_SW.kicad_pcb from below]

Board: 2 copper layers, 16.4 x 13.5 mm, 15 parts (13 on the bottom side), 15 nets.
