PGRacing/WHEEL-07/CODE/WHEEL_07_F405/WHEEL_07_F405.ioc

Mcu.UserName=STM32F405RGTx
PA13.Signal=SYS_JTMS-SWDIO
PA14.Signal=SYS_JTCK-SWCLK
PA4.GPIO_Label=PADDLE_DOWN
PA4.Signal=GPXTI4
PA5.GPIO_Label=PADDLE_UP
PA5.Signal=GPXTI5
PA6.GPIO_Label=WHEEL_BTN1
PA6.Signal=GPIO_Input
PA7.GPIO_Label=WHEEL_BTN2
PA7.Signal=GPIO_Input
PB0.GPIO_Label=WHEEL_BTN5
PB0.Signal=GPIO_Input
PB1.GPIO_Label=WHEEL_BTN6
PB1.Signal=GPIO_Input
PB3.Signal=SYS_JTDO-SWO
PB5.Signal=CAN2_RX
PB6.Signal=CAN2_TX
PB8.Signal=CAN1_RX
PB9.Signal=CAN1_TX
PC0.Signal=ADCx_IN10
PC1.Signal=ADCx_IN11
PC13-ANTI_TAMP.GPIO_Label=STATUS_LED
PC13-ANTI_TAMP.Signal=GPIO_Output
PC2.Signal=ADCx_IN12
PC3.Signal=ADCx_IN13
PC4.GPIO_Label=WHEEL_BTN3
PC4.Signal=GPIO_Input
PC5.GPIO_Label=WHEEL_BTN4
PC5.Signal=GPIO_Input
