PGRacing/WHEEL-07/CODE/WHEEL_07_F405/Core/Inc/adc.h

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
/* Define to prevent recursive inclusion -------------------------------------*/
#ifndef __ADC_H__
#define __ADC_H__

#ifdef __cplusplus
extern "C" {
#endif

/* Includes ------------------------------------------------------------------*/
#include "main.h"

/* USER CODE BEGIN Includes */
#include "FreeRTOS.h"
#include "semphr.h"
/* USER CODE END Includes */

extern ADC_HandleTypeDef hadc1;

/* USER CODE BEGIN Private defines */
#define ADC_CHANNEL_COUNT 4
#define AVERAGING_ITERNATION_COUNT 20
/* USER CODE END Private defines */

void MX_ADC1_Init(void);

/* USER CODE BEGIN Prototypes */
extern uint32_t adcRawData[ADC_CHANNEL_COUNT];
extern SemaphoreHandle_t adcConvReadySemaphore;

/**
* @brief Function implementing the adcTask thread.
* @param argument: Not used
* @retval None
*/
void adcTaskStart(void *argument);

void HAL_ADC_ConvCpltCallback(ADC_HandleTypeDef* hadc);
/* USER CODE END Prototypes */

#ifdef __cplusplus
}
#endif

#endif /* __ADC_H__ */
