PGRacing/WHEEL-07/(commit log)

2023-02-22 PCB schematics with MCU
    [WHEEL-07.kicad_pcb, WHEEL-07.kicad_sch]
2023-02-24 Finished schematics
    [0022057025.stp, 22-05-7025.stp, 87437-0243.stp, 87438-0243.stp, WHEEL-07.kicad_pcb, WHEEL-07.kicad_sch, can_bus.kicad_sch, headers.kicad_sch]
2023-02-24 Configured library loader for this project
    [WHEEL-07.kicad_sch, headers.kicad_sch, power.kicad_sch]
2023-02-24 Finished power section
    [WHEEL-07.kicad_sch, power.kicad_sch]
2023-02-25 Added Grayhill 56DP30 rotary switch
    [ROTARY_SW.kicad_pcb, ROTARY_SW.kicad_sch, ROTARY_SW.step]
2023-02-25 Modified layout
    [WHEEL-07.kicad_pcb, WHEEL-07.kicad_sch, can_bus.kicad_sch, headers.kicad_sch, power.kicad_sch]
2023-02-25 Added paddles hardware debouncing to PCB
    [WHEEL-07.kicad_pcb, WHEEL-07.kicad_sch, headers.kicad_sch]
2023-02-25 Added rotaries
    [WHEEL-07.kicad_pcb, WHEEL-07.kicad_sch, headers.kicad_sch]
2023-02-27 Added mockup drawing for steering wheel
2023-03-05 Modified schematics & assigned all footprints
    [ROTARY_SW.SLDASM, WHEEL-07.kicad_pcb, WHEEL-07.kicad_sch, can_bus.kicad_sch, headers.kicad_sch, power.kicad_sch]
2023-03-06 Changed connectors setup
    [WHEEL-07.kicad_pcb, WHEEL-07.kicad_sch, WHEEL-07.step, can_bus.kicad_sch, headers.kicad_sch, power.kicad_sch]
2023-03-17 Finished layout
    [WHEEL-07-B_Cu.gbr, WHEEL-07-B_Mask.gbr, WHEEL-07-B_Paste.gbr, WHEEL-07-B_Silkscreen.gbr, WHEEL-07-Edge_Cuts.gbr, WHEEL-07-F_Cu.gbr, WHEEL-07-F_Mask.gbr, WHEEL-07-F_Paste.gbr]
2023-05-17 Before exporting power section
    [WHEEL-07.kicad_pcb]
2023-06-03 WORKING CANBUS
2023-06-10 Working ADC DMA on FreeRTOS
    [ROTARY_SW.kicad_pcb]
2023-06-10 Working MUX switch with ADC DMA + FreeRTOS
    [headers.kicad_sch]
2023-06-11 Software debouncing with FreeRTOS timer idea
2023-06-11 Changed software timer to hardware timer
2023-06-25 Working CANBUS with queue
2023-06-25 Added user buttons can handler + debouncing
2023-09-22 Newest update after all competitions 2023
    [ROTARY_SW-B_Cu.gbr, ROTARY_SW-B_Mask.gbr, ROTARY_SW-B_Paste.gbr, ROTARY_SW-B_Silkscreen.gbr, ROTARY_SW-Edge_Cuts.gbr, ROTARY_SW-F_Cu.gbr, ROTARY_SW-F_Mask.gbr, ROTARY_SW-F_Paste.gbr]
2024-10-06 Added usage of second rotary switch
2024-10-06 WIP Improved rotary sw knob model
    [ROTARY_SW.SLDASM, Rotary_Knob.SLDPRT, Rotary_Knob.STL, Rotary_Knob_v2_smaller.STL]
2024-10-11 New 3D housing
    [HOUSING_WHL - HOUSING_WHL_BOTTOM-1.STL, HOUSING_WHL - WHEEL-07.step-1 MP2332HGTL-P.step-1 COMPOUND-1.step-1.STL, HOUSING_WHL - WHEEL-07.step-1 Molex_PicoBlade_53047-0210_1x02_P1.25mm_Vertical.wrl.step-1 COMPOUND-0.step-1.STL, HOUSING_WHL - WHEEL-07.step-1 NL27WZ14DTT1G.step-1 COMPOUND.step-1.STL, HOUSING_WHL - WHEEL-07.step-1 WHEEL-07 PCB.step-1.STL, HOUSING_WHL.SLDASM, HOUSING_WHL_BOTTOM.SLDPRT,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]
2024-10-12 Changed power supply section for 2 x LDO40
    [53254-0670.stp, LDO40.stp, LDO40LPU33RY.stp, WHEEL-07.csv, WHEEL-07.kicad_pcb, WHEEL-07.kicad_sch, power.kicad_sch]
2024-12-15 Revised board with 2 x LDO40 and cleaned-up schematics
    [BOM-WHEEL-07.csv, BOM-WHEEL-07_2.csv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]
