PGRacing/WHEEL-07/(notices)

Notices in the files:
CODE/WHEEL_07_F405/Core/Src/adc.c:
Copyright (c) 2023 STMicroelectronics.
All rights reserved.
This software is licensed under terms that can be found in the LICENSE file
